leminhquang5320/QuadratureStroboscope/CAD/Stroboscope Assembly v1.SLDASM

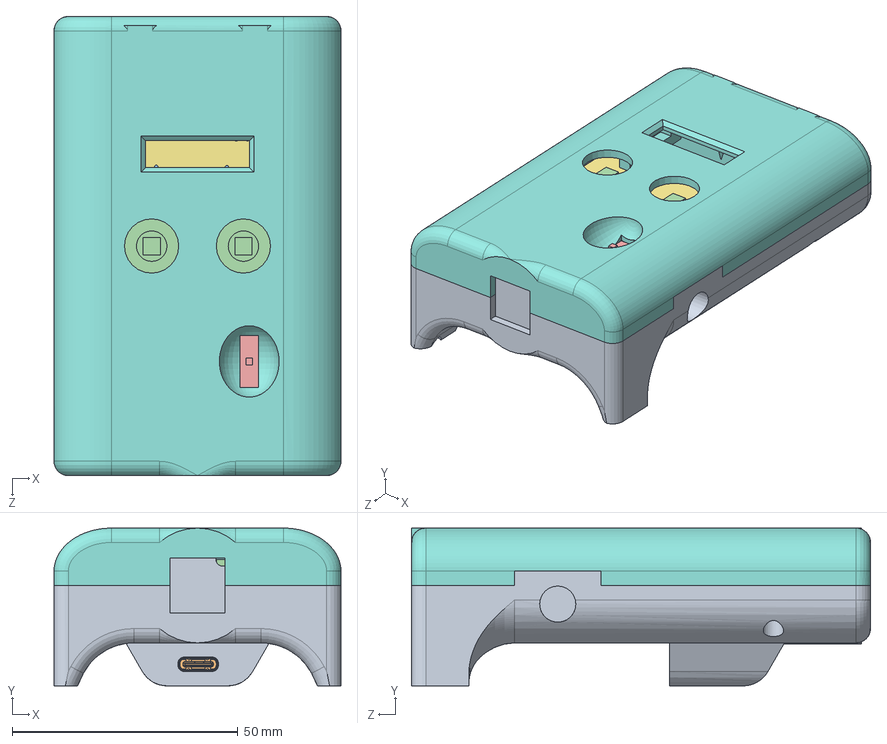
[picture p1: CAD file, 2024-02-06]
CAD/Stroboscope Assembly v1.SLDASM
63.5 x 34.9 x 101.6 mm
Chassis-Base
COMPOUND.step
stroboscope_usb_c_0v1 PCB.step
SOLID.step x 2
SOLID-0.step
COMPOUND-1.step
stroboscope_main_0v1 PCB.step
Chassis-Cap
