leminhquang5320/QuadratureStroboscope/Circuit/stroboscope_main_0v1/stroboscope_main_0v1.step

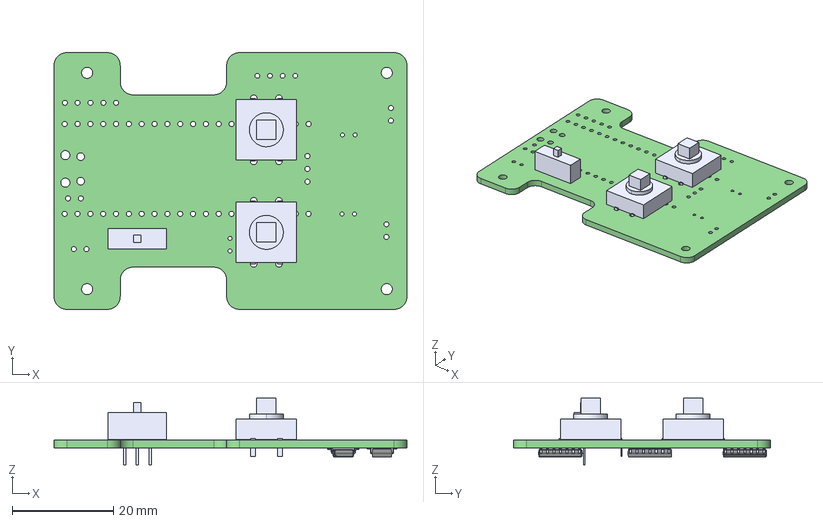
[picture p2: CAD file, 2024-02-06]
Circuit/stroboscope_main_0v1/stroboscope_main_0v1.step
69.9 x 50.8 x 13.3 mm
stroboscope_main_0v1 PCB
