leminhquang5320/QuadratureStroboscope/Circuit/stroboscope_usb_c_0v1/stroboscope_main_0v1.step.SLDASM

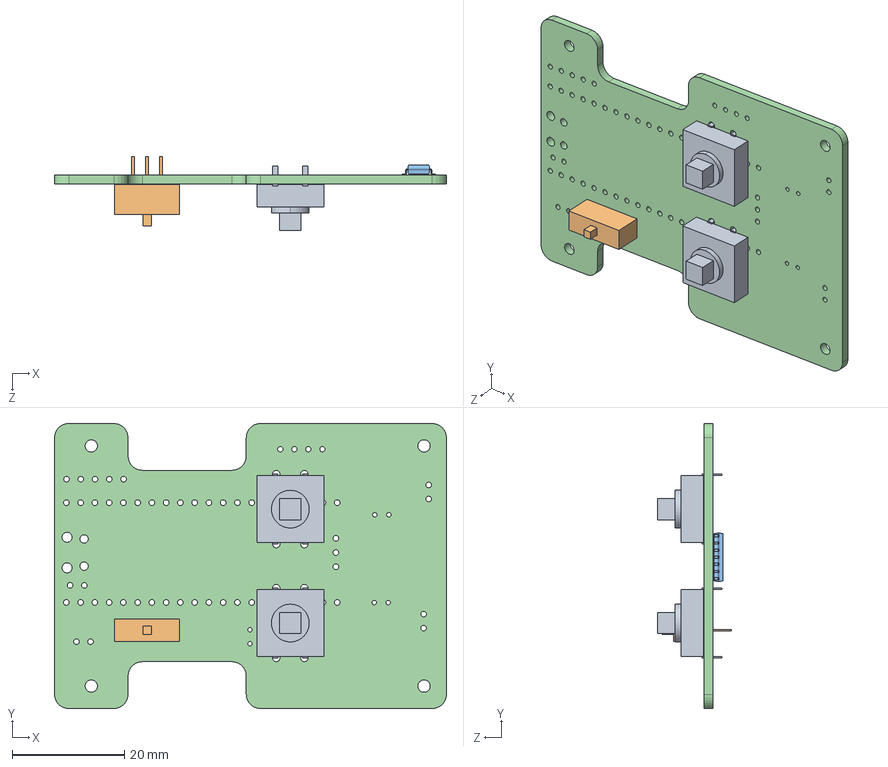
[picture p3: CAD file, 2024-02-06]
Circuit/stroboscope_usb_c_0v1/stroboscope_main_0v1.step.SLDASM
69.8 x 50.8 x 13.3 mm
SOLID.step x 2
SOLID-0.step
COMPOUND-1.step
stroboscope_main_0v1 PCB.step
