leminhquang5320/QuadratureStroboscope/CAD/STL/UM2_ChassisALL.3mf

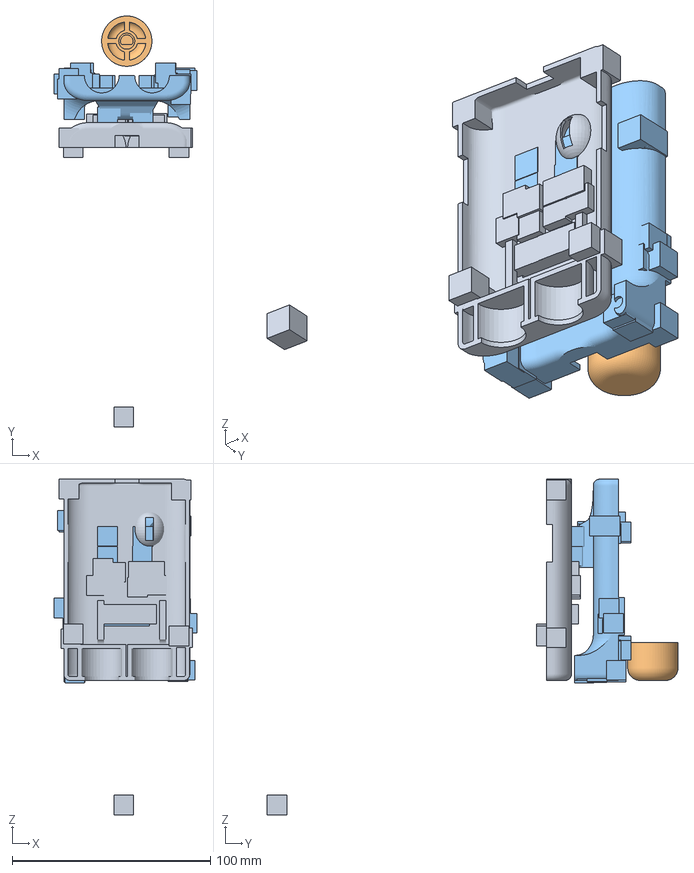
[picture p4: CAD file, 2024-02-06]
CAD/STL/UM2_ChassisALL.3mf
72.0 x 207.4 x 169.4 mm
Chassis-Cap.STL
Chassis-Knob.STL
Chassis-Base.STL
