leminhquang5320/QuadratureStroboscope/CAD/Stroboscope Chassis Concept 1.1.SLDPRT

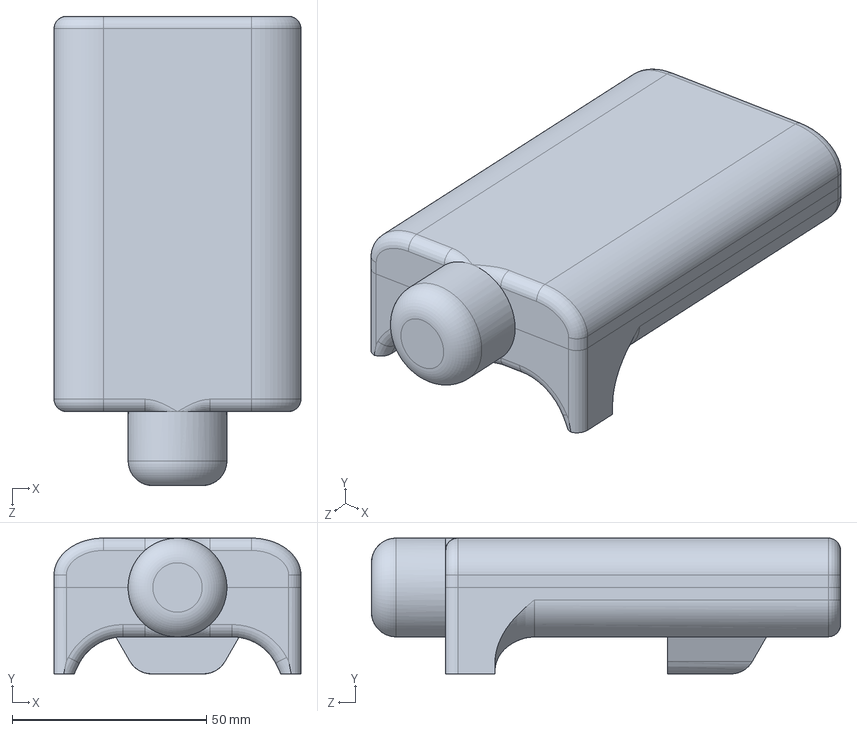
[picture p6: CAD file, 2024-02-06]
CAD/Stroboscope Chassis Concept 1.1.SLDPRT
63.5 x 34.9 x 120.6 mm
