leminhquang5320/QuadratureStroboscope/CAD/Chassis-Base.SLDPRT

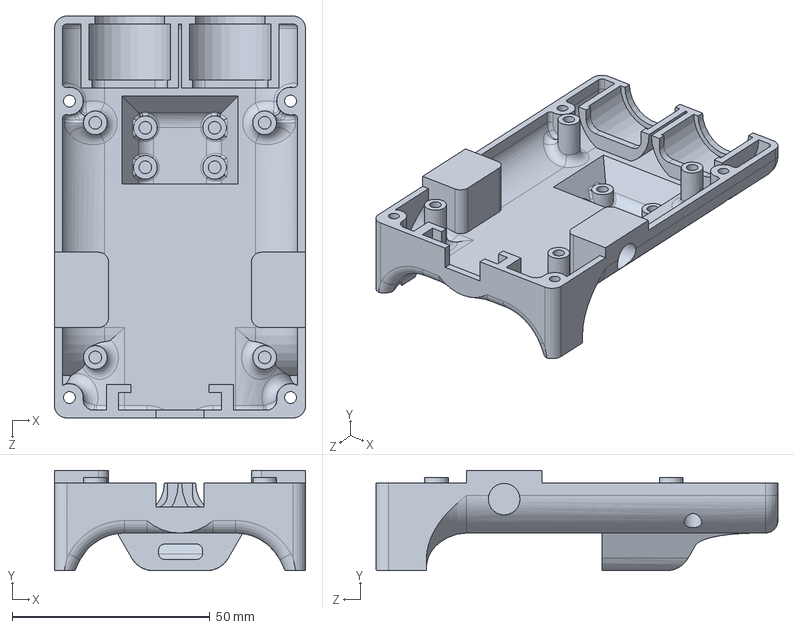
[picture p7: CAD file, 2024-02-06]
CAD/Chassis-Base.SLDPRT
63.5 x 25.4 x 101.6 mm
