leminhquang5320/QuadratureStroboscope/CAD/PCB Outline.DXF

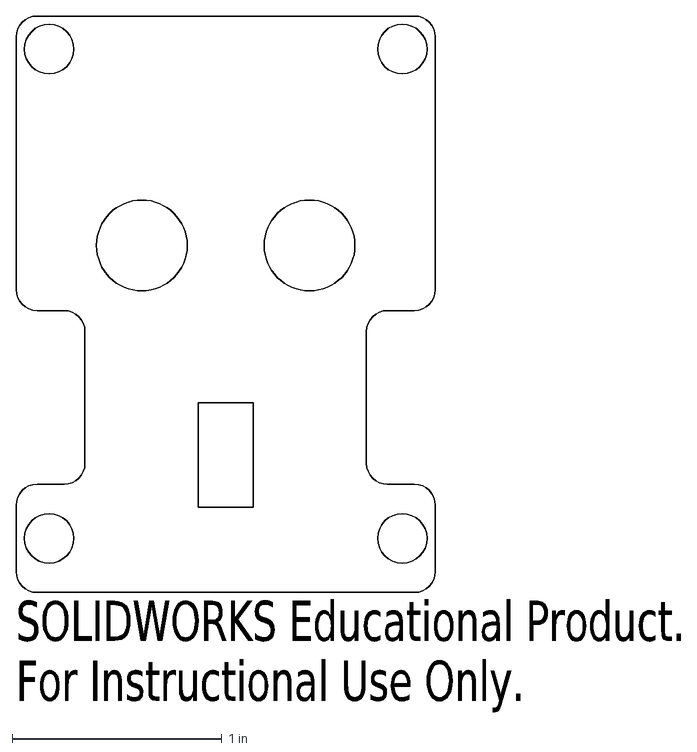
[picture p8: CAD file, 2024-02-06]
CAD/PCB Outline.DXF
SOLIDWORKS Educational Product.
For Instructional Use Only.
