leminhquang5320/QuadratureStroboscope/CAD/Chassis-Cap.SLDPRT

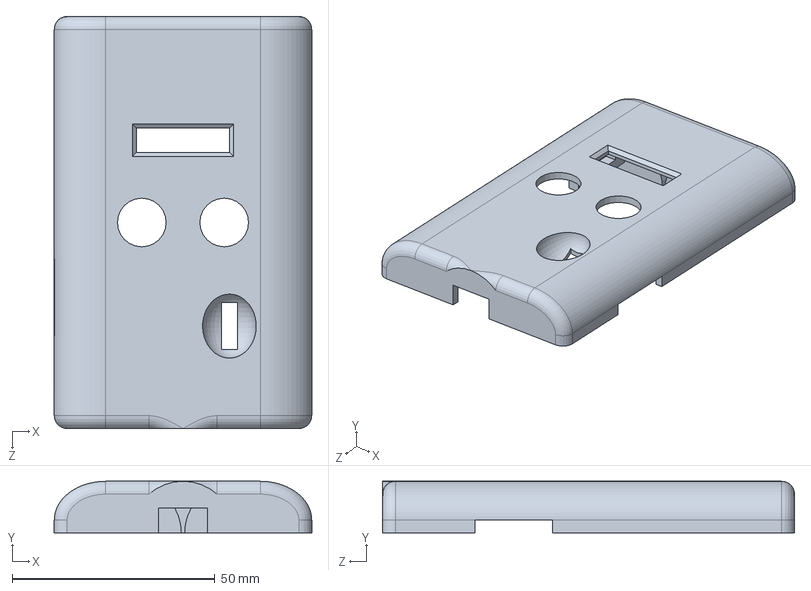
[picture p9: CAD file, 2024-02-06]
CAD/Chassis-Cap.SLDPRT
63.5 x 12.7 x 101.6 mm
