leminhquang5320/QuadratureStroboscope/CAD/Prop Plate.SLDPRT

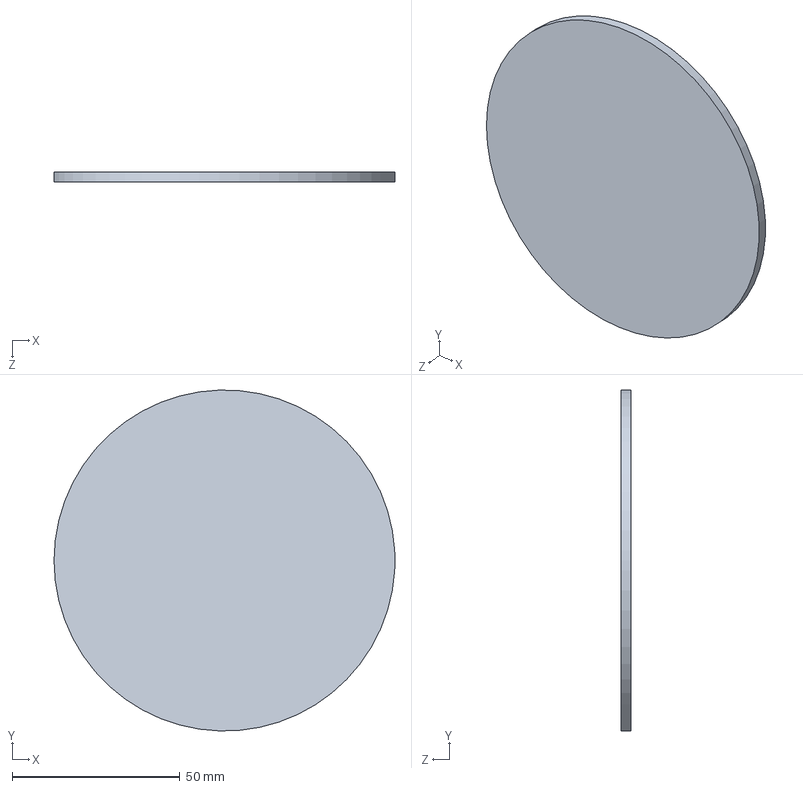
[picture p10: CAD file, 2024-02-06]
CAD/Prop Plate.SLDPRT
101.6 x 101.6 x 3.00 mm
