leminhquang5320/QuadratureStroboscope/CAD/Chassis-Knob.SLDPRT

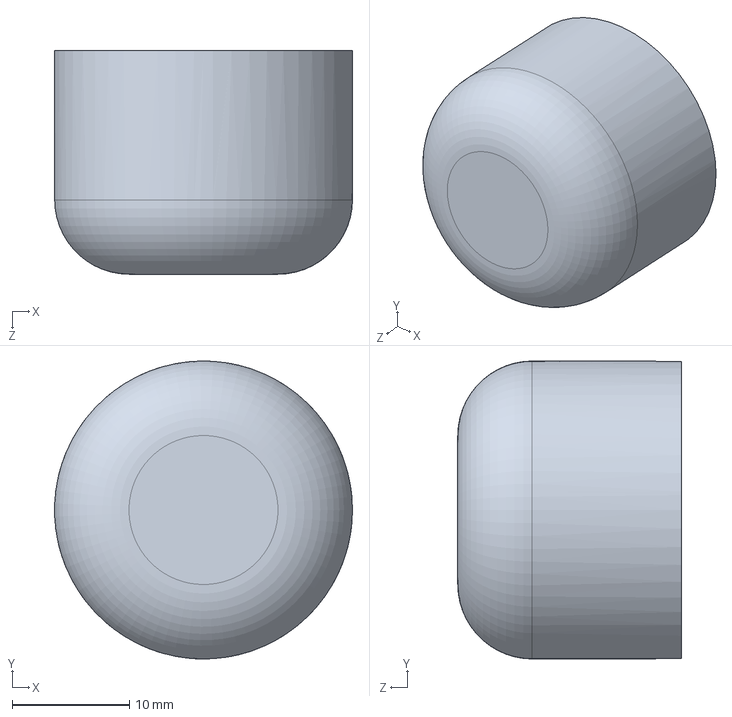
[picture p11: CAD file, 2024-02-06]
CAD/Chassis-Knob.SLDPRT
25.4 x 25.4 x 19.0 mm
