leminhquang5320/QuadratureStroboscope/Circuit/stroboscope_usb_c_0v1/stroboscope_usb_c_0v1.step

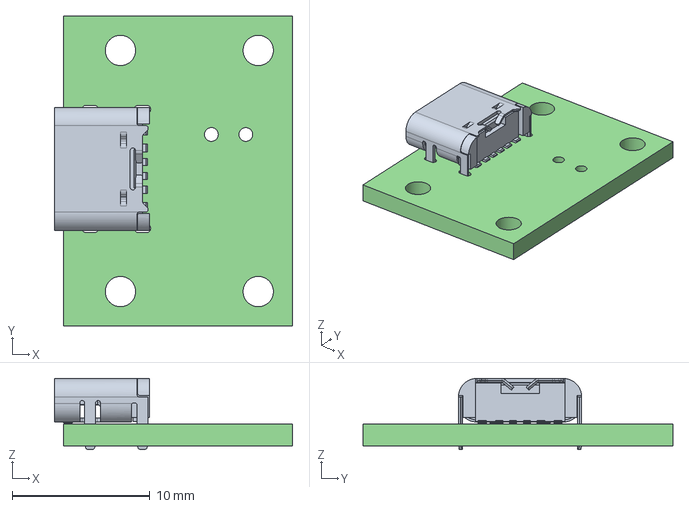
[picture p12: CAD file, 2024-02-06]
Circuit/stroboscope_usb_c_0v1/stroboscope_usb_c_0v1.step
17.3 x 22.5 x 5.16 mm
stroboscope_usb_c_0v1 PCB
