leminhquang5320/QuadratureStroboscope/Circuit/stroboscope_usb_c_0v1/type c outline.DXF

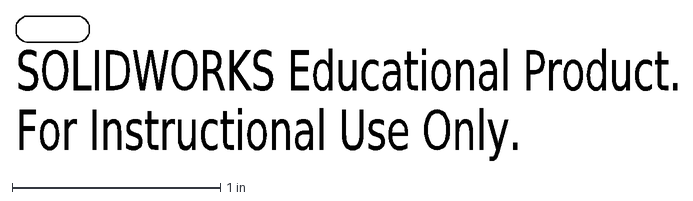
[picture p13: CAD file, 2024-02-06]
Circuit/stroboscope_usb_c_0v1/type c outline.DXF
SOLIDWORKS Educational Product.
For Instructional Use Only.
