leminhquang5320/QuadratureStroboscope/(list of files, cad)

Other CAD files:
Circuit/stroboscope_usb_c_0v1/CD4013BM.step.SLDASM
Circuit/stroboscope_usb_c_0v1/CD74HCU04M96.step.SLDASM
Circuit/stroboscope_usb_c_0v1/PTS125SM85-2_LFS.step.SLDASM
Circuit/stroboscope_usb_c_0v1/stroboscope_main_0v1 PCB.step.SLDPRT
Circuit/stroboscope_usb_c_0v1/stroboscope_usb_c_0v1.step.SLDASM
Circuit/stroboscope_usb_c_0v1/Switch_Slide_EG1218.step.SLDASM
Circuit/stroboscope_usb_c_0v1/COMPOUND.step.SLDPRT
Circuit/stroboscope_usb_c_0v1/SOLID.step.SLDPRT
Circuit/stroboscope_usb_c_0v1/stroboscope_usb_c_0v1 PCB.step.SLDPRT
Circuit/stroboscope_usb_c_0v1/SOLID-0.step.SLDPRT
Circuit/stroboscope_usb_c_0v1/COMPOUND-1.step.SLDPRT
CAD/STL/Chassis-Base.STL
CAD/STL/Chassis-Cap.STL
CAD/STL/Chassis-Knob.STL
CAD/STL/Prop Plate.STL
Circuit/stroboscope_usb_c_0v1/2171750001.step.SLDASM
