leminhquang5320/QuadratureStroboscope/Circuit/stroboscope_usb_c_0v1/stroboscope_usb_c_0v1.kicad_pcb

## KiCad design Circuit/stroboscope_usb_c_0v1/stroboscope_usb_c_0v1.kicad_pcb (2024-02-06)

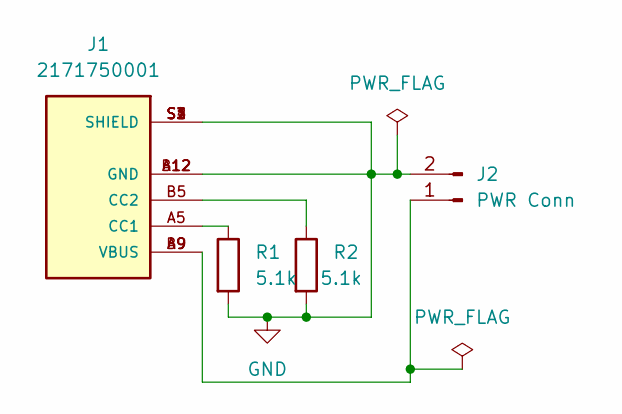
[picture p14: schematic stroboscope_usb_c_0v1.kicad_sch]

Parts:
J1: 2171750001; MOLEX_2171750001; PARTREV A1
J2: PWR Conn; JST_XH_B2B-XH-A_1x02_P2.50mm_Vertical
R1, R2: 5.1k; R_0805_2012Metric_Pad1.20x1.40mm_HandSolder

Connections:
GND: J1.A12 (GND), J1.B12 (GND), J1.S1 (SHIELD), J1.S2 (SHIELD), J1.S3 (SHIELD), J1.S4 (SHIELD), J2.2, R1.2, R2.2
unnamed: J1.A5 (CC1), R1.1
unnamed: J1.A9 (VBUS), J1.B9 (VBUS), J2.1
unnamed: J1.B5 (CC2), R2.1

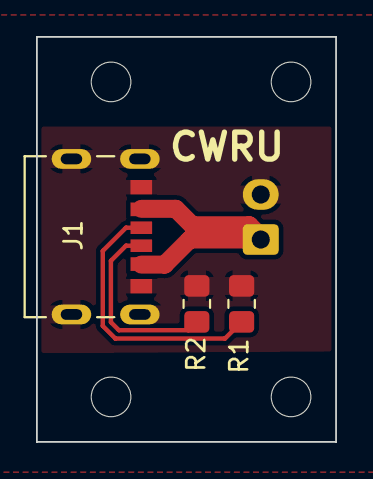
[picture p15: board stroboscope_usb_c_0v1.kicad_pcb from above]

Board: 2 copper layers, 16.6 x 22.5 mm, 4 parts (1 on the bottom side), 4 nets.
