leminhquang5320/QuadratureStroboscope/Circuit/stroboscope_main_0v1/stroboscope_main_0v1.kicad_pcb

## KiCad design Circuit/stroboscope_main_0v1/stroboscope_main_0v1.kicad_pcb (2024-02-06)

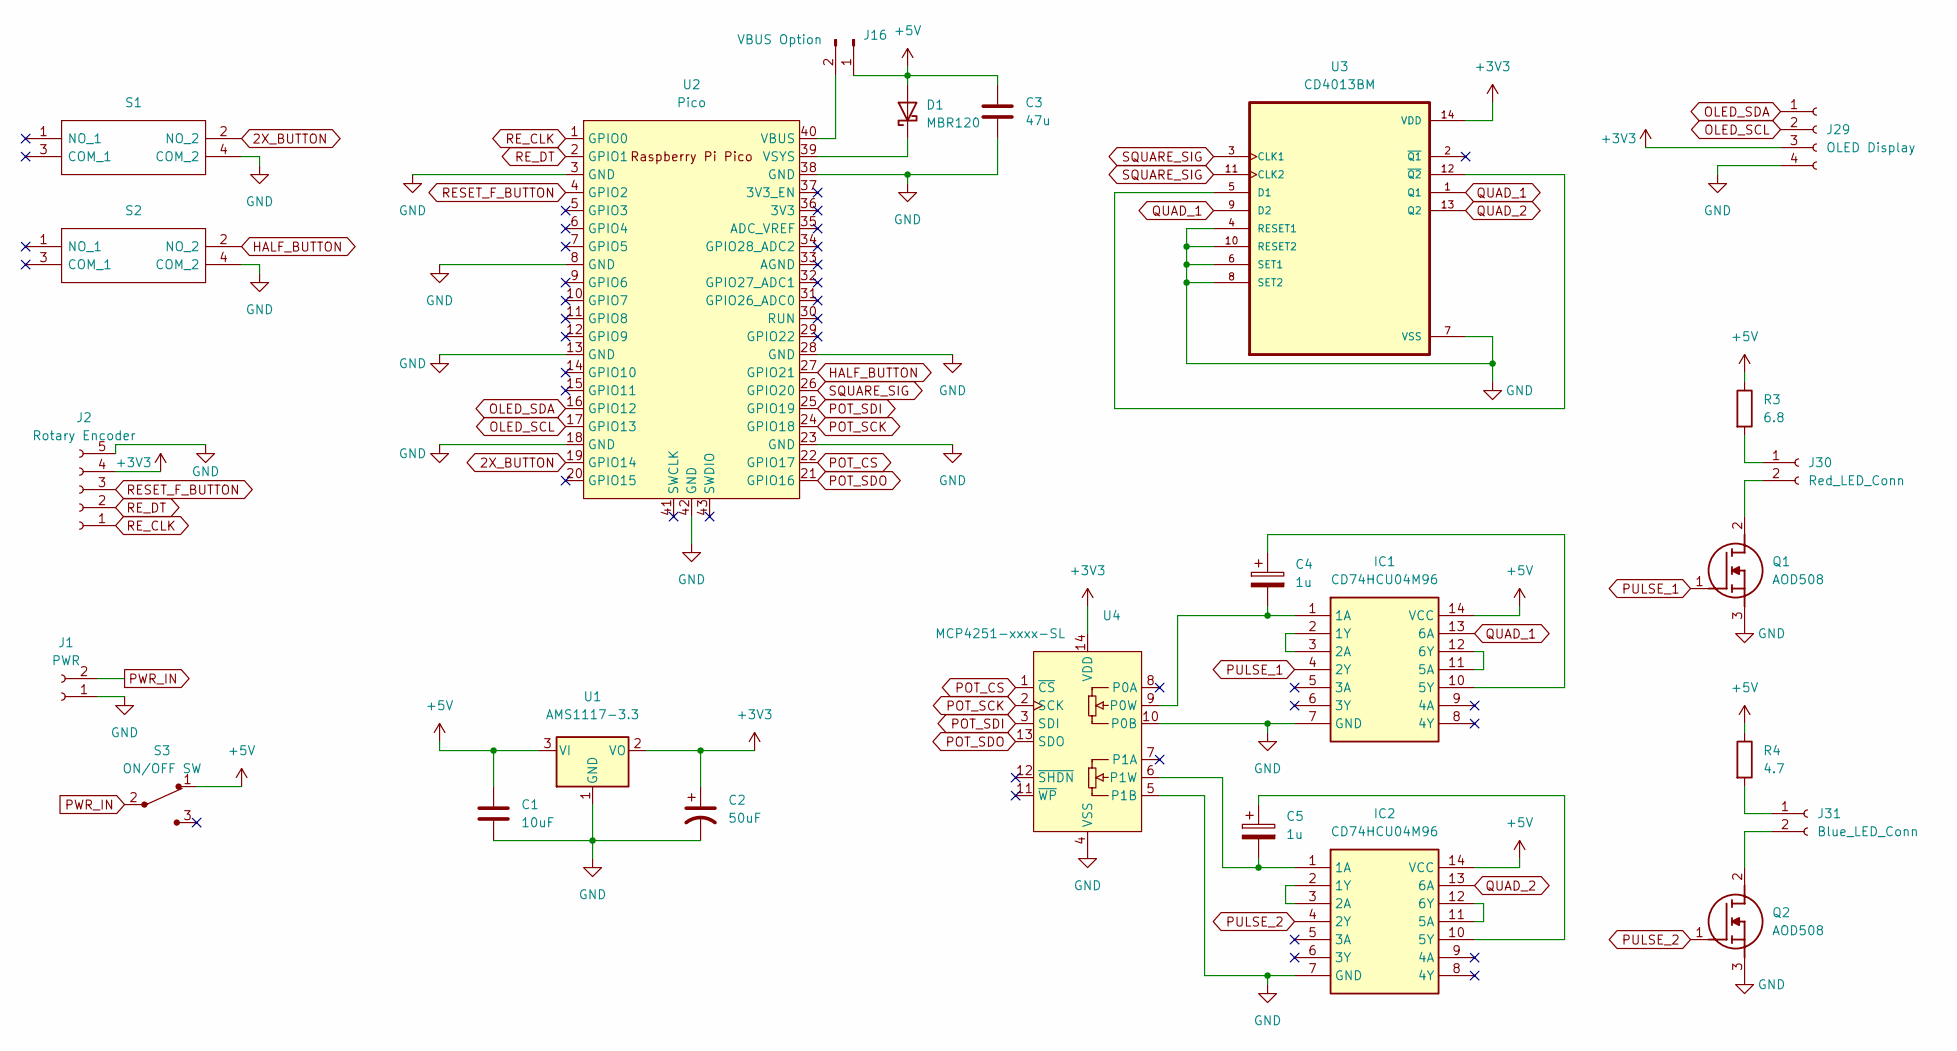
[picture p16: schematic stroboscope_main_0v1.kicad_sch, Stroboscope Main Controller]

Parts:
C1: 10uF; C_0603_1608Metric_Pad1.08x0.95mm_HandSolder
C2: 50uF; CP_Radial_D6.3mm_P2.50mm
C3: 47u; C_0603_1608Metric_Pad1.08x0.95mm_HandSolder
C4, C5: 1u; CP_Radial_D6.3mm_P2.50mm
D1: MBR120; D_SOD-123
IC1, IC2: CD74HCU04M96; SOIC127P600X175-14N; Manufacturer_Part_Number CD74HCU04M96; Mouser Part Number 595-CD74HCU04M96
J1: PWR; JST_XH_B2B-XH-A_1x02_P2.50mm_Vertical
J2: Rotary Encoder; PinHeader_1x05_P2.54mm_Vertical
J16: VBUS Option; PinHeader_1x02_P2.54mm_Vertical
J29: OLED Display; JST_XH_B4B-XH-A_1x04_P2.50mm_Vertical
J30: Red_LED_Conn; JST_XH_B2B-XH-A_1x02_P2.50mm_Vertical
J31: Blue_LED_Conn; JST_XH_B2B-XH-A_1x02_P2.50mm_Vertical
Q1, Q2: AOD508; Manufacturer_Part_Number AOD508
R3: 6.8; R_2512_6332Metric_Pad1.40x3.35mm_HandSolder
R4: 4.7; R_2512_6332Metric_Pad1.40x3.35mm_HandSolder
S1, S2: PTS125SM85-2_LFS; PTS125SM432LFS; Manufacturer_Part_Number PTS125SM85-2 LFS
S3: ON/OFF SW; Switch_Slide_11.6x4mm_EG1218; MPN EG1218; Digi-Key_PN EG1903-ND
U1: AMS1117-3.3; SOT-223-3_TabPin2
U2: Pico; RPi_Pico_SMD_TH
U3: CD4013BM; SOIC127P600X175-14N
U4: MCP4251-xxxx-SL; SOIC-14_3.9x8.7mm_P1.27mm

Connections:
2X_BUTTON: S1.2 (NO_2), U2.19 (GPIO14)
+3V3: C2.1, J2.4, J29.3, U1.2 (VO), U3.14 (VDD), U4.14 (VDD)
+5V: C1.1, C3.1, D1.2 (A), IC1.14 (VCC), IC2.14 (VCC), J16.1, R3.1, R4.1, S3.1, U1.3 (VI)
GND: C1.2, C2.2, C3.2, IC1.7 (GND), IC2.7 (GND), J1.1, J2.5, J29.4, Q1.3 (S), Q2.3 (S), S1.4 (COM_2), S2.4 (COM_2), U1.1 (GND), U2.3 (GND), U2.8 (GND), U2.13 (GND), U2.18 (GND), U2.23 (GND), U2.28 (GND), U2.38 (GND), U2.42 (GND), U3.4 (RESET1), U3.6 (SET1), U3.7 (VSS), U3.8 (SET2), U3.10 (RESET2), U4.4 (VSS), U4.5 (P1B), U4.10 (P0B)
HALF_BUTTON: S2.2 (NO_2), U2.27 (GPIO21)
unnamed: D1.1 (K), U2.39 (VSYS)
unnamed: C4.2, IC1.1 (1A), U4.9 (P0W)
unnamed: IC1.2 (1Y), IC1.3 (2A)
unnamed: C4.1, IC1.10 (5Y)
unnamed: IC1.11 (5A), IC1.12 (6Y)
unnamed: C5.2, IC2.1 (1A), U4.6 (P1W)
unnamed: IC2.2 (1Y), IC2.3 (2A)
unnamed: C5.1, IC2.10 (5Y)
unnamed: IC2.11 (5A), IC2.12 (6Y)
unnamed: J16.2, U2.40 (VBUS)
unnamed: J30.1, R3.2
unnamed: J30.2, Q1.2 (D)
unnamed: J31.1, R4.2
unnamed: J31.2, Q2.2 (D)
unnamed: U3.5 (D1), U3.12 (~Q2)
OLED_SCL: J29.2, U2.17 (GPIO13)
OLED_SDA: J29.1, U2.16 (GPIO12)
POT_CS: U2.22 (GPIO17), U4.1 (~CS)
POT_SCK: U2.24 (GPIO18), U4.2 (SCK)
POT_SDI: U2.25 (GPIO19), U4.3 (SDI)
POT_SDO: U2.21 (GPIO16), U4.13 (SDO)
PULSE_1: IC1.4 (2Y), Q1.1 (G)
PULSE_2: IC2.4 (2Y), Q2.1 (G)
PWR_IN: J1.2, S3.2
QUAD_1: IC1.13 (6A), U3.1 (Q1), U3.9 (D2)
QUAD_2: IC2.13 (6A), U3.13 (Q2)
RESET_F_BUTTON: J2.3, U2.4 (GPIO2)
RE_CLK: J2.1, U2.1 (GPIO0)
RE_DT: J2.2, U2.2 (GPIO1)
SQUARE_SIG: U2.26 (GPIO20), U3.3 (CLK1), U3.11 (CLK2)

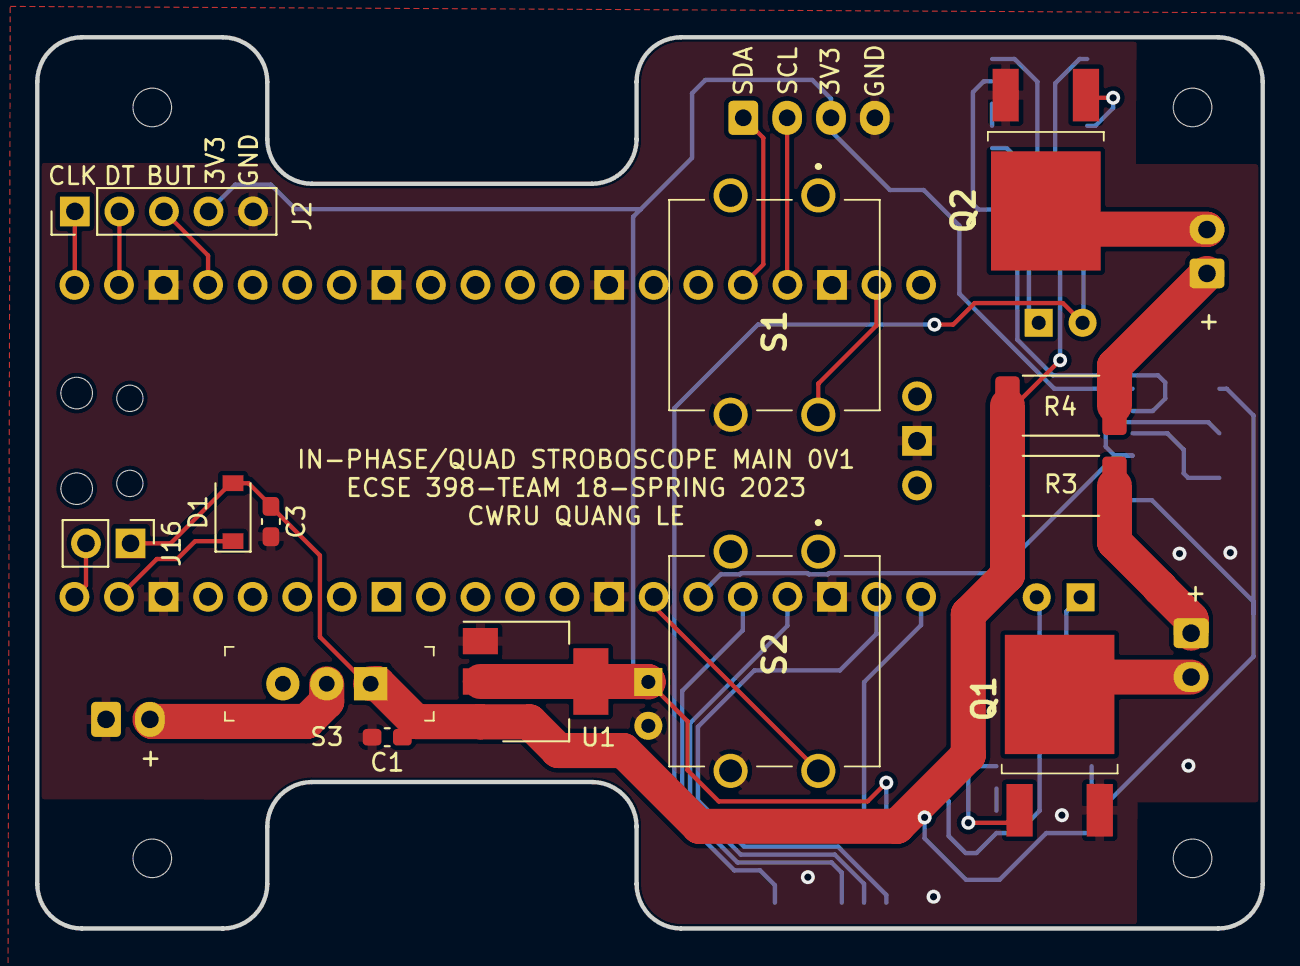
[picture p17: board stroboscope_main_0v1.kicad_pcb from above]

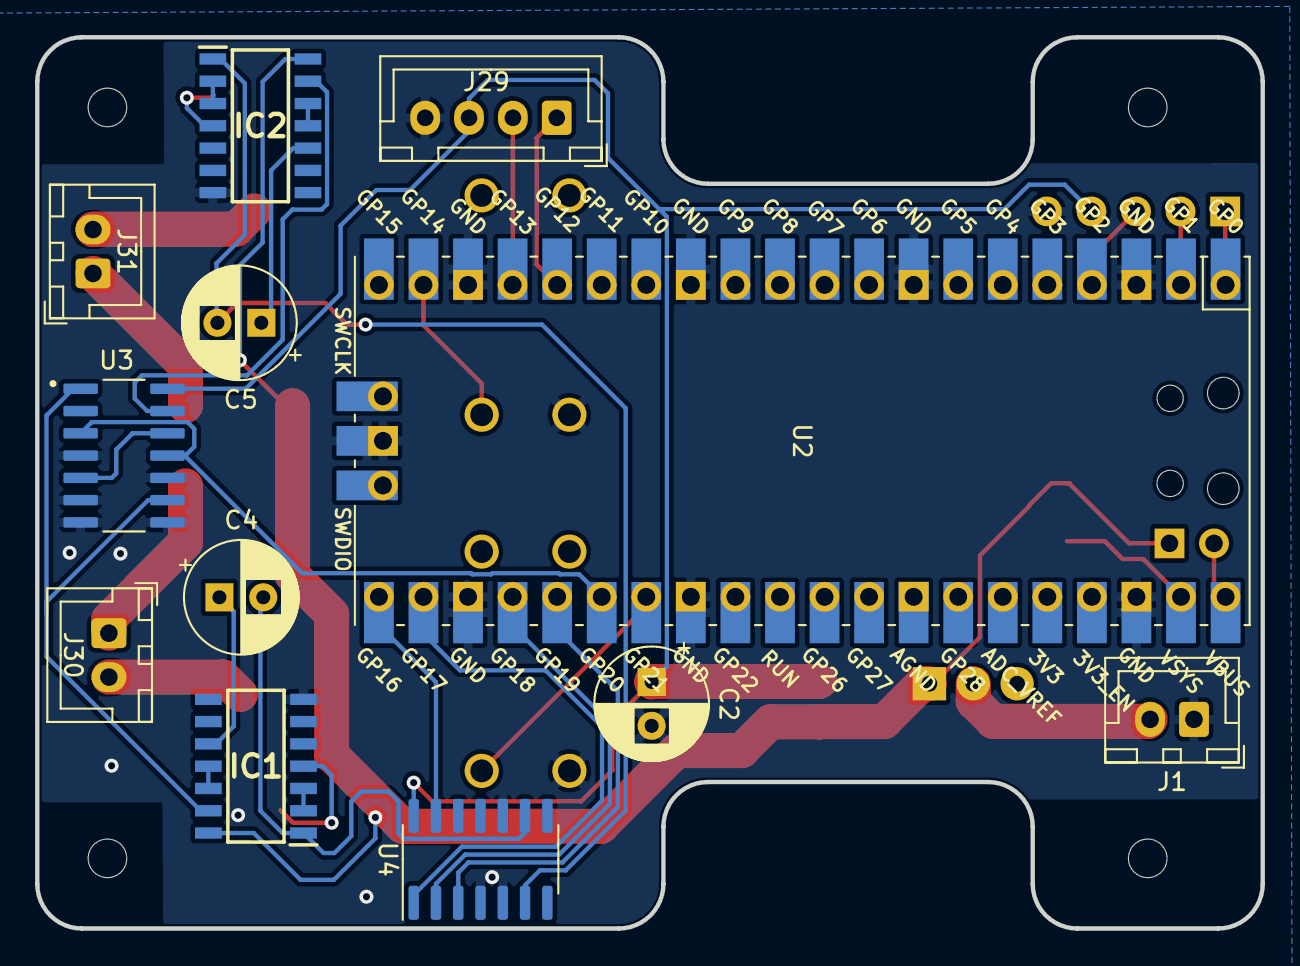
[picture p18: board stroboscope_main_0v1.kicad_pcb from below]

Board: 2 copper layers, 69.8 x 50.8 mm, 25 parts (12 on the bottom side), 35 nets.
